alexandrefelipemuller/slowduino/resources/Schematic_Slowduino-injection_2025-11-14.png

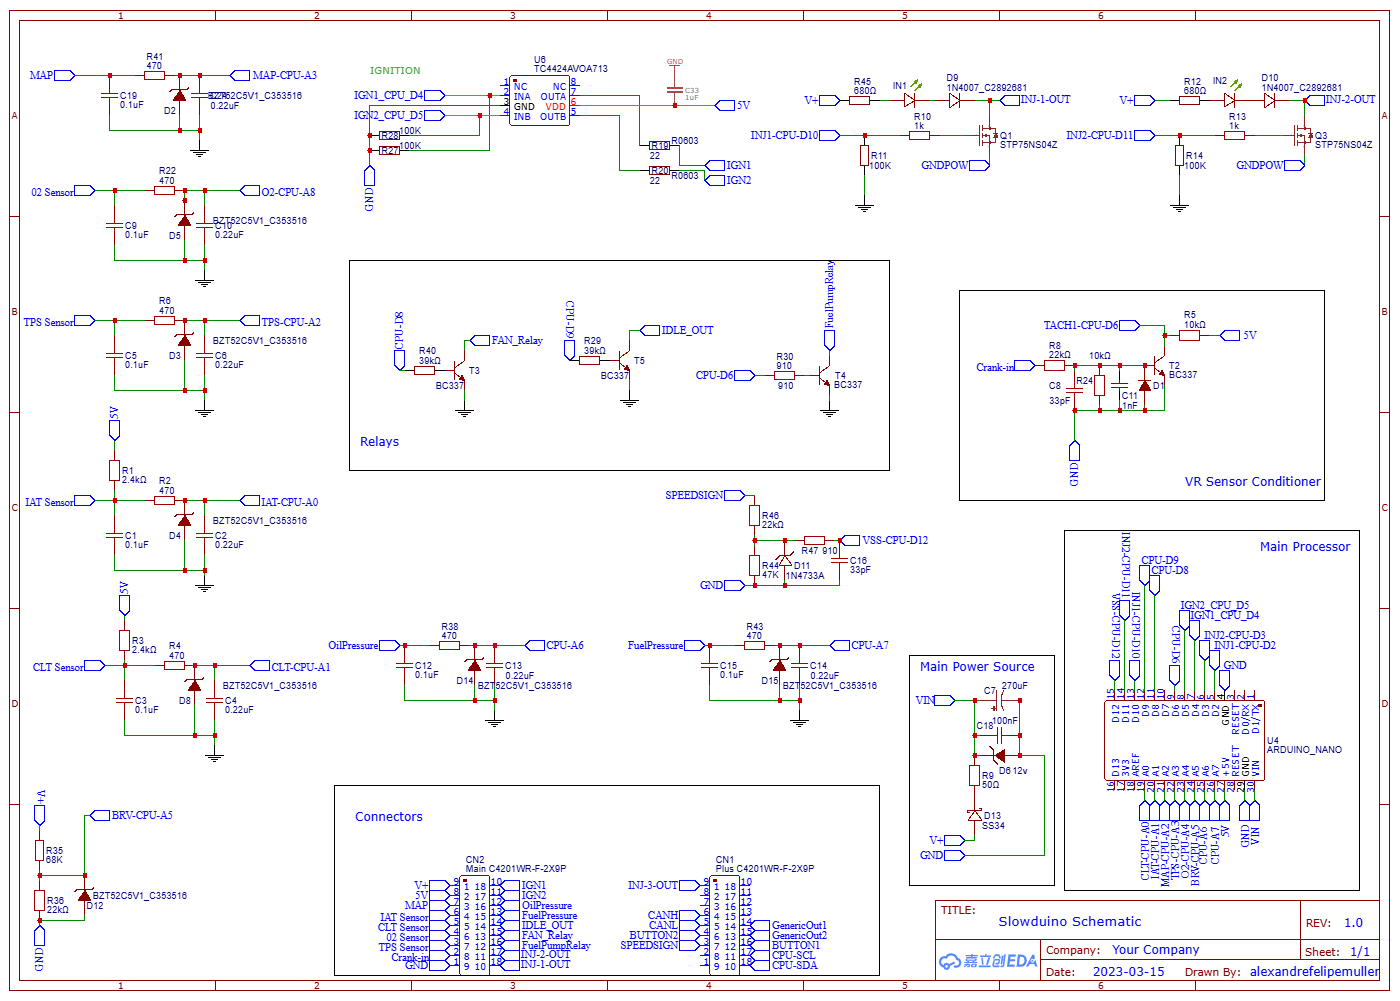
resources/Schematic_Slowduino-injection_2025-11-14.png
