alexandrefelipemuller/slowduino/resources/SlowduinoCase.stl

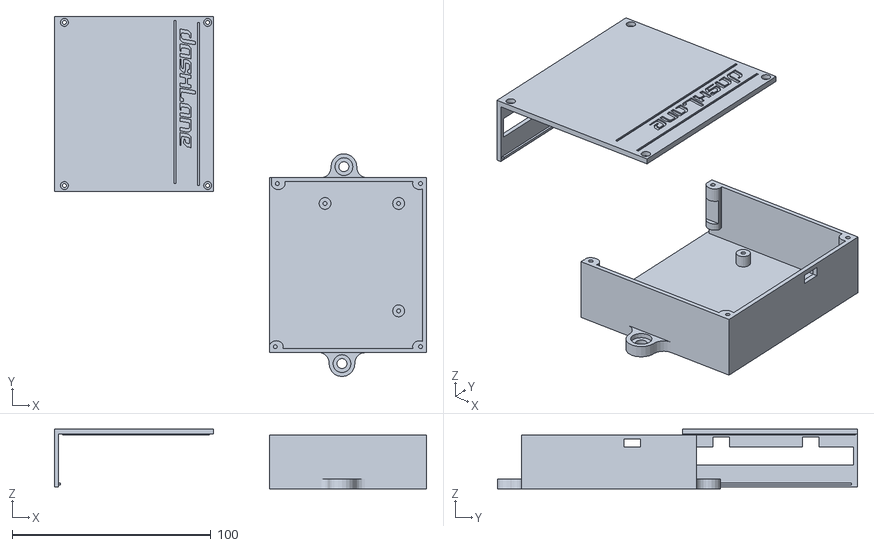
[picture p4: CAD file, 2025-11-05]
resources/SlowduinoCase.stl
187.0 x 181.0 x 30.0
