alexandrefelipemuller/slowduino/(list of files, drawings)

Other design files:
simulator/basics.sim1
