alexandrefelipemuller/slowduino/slowduino/config.h

#define CONFIG_H
#include <Arduino.h>
#include "globals.h"  // CALIB_POINTS (usado pelas tabelas de calibração padrão abaixo)
#define TABLE_SIZE_X        16   // Eixo X (RPM) - 16 pontos
#define TABLE_SIZE_Y        16   // Eixo Y (MAP/TPS) - 16 pontos
#define TIMER1_PRESCALER    256
#define TIMER1_RESOLUTION   16.0  // microsegundos por tick (não usado diretamente, apenas doc)
#define US_TO_TIMER1(us)    ((uint16_t)((us) / 16))
#define TIMER1_TO_US(ticks) ((uint32_t)(ticks) * 16U)
#define FILTER_MAP          20   // MAP: resposta rápida
#define FILTER_TPS          50   // TPS: média
#define FILTER_CLT         180   // CLT: muito filtrado (lento)
#define FILTER_IAT         180   // IAT: muito filtrado (lento)
#define FILTER_O2          128   // O2: média-alta
#define FILTER_BAT         128   // Bateria: média-alta
#define FILTER_OIL_PRESS   100   // Pressão óleo: média
#define FILTER_FUEL_PRESS  100   // Pressão combustível: média
#define ADC_MIN             0
#define ADC_MAX          1023
#define ADC_VREF         5000    // 5V
#define BAT_MULTIPLIER    767    // * 100 para evitar float
const uint16_t DEFAULT_CLT_CALIB_ADC[CALIB_POINTS] PROGMEM = {
  980, 920, 850, 750, 620, 480, 360, 120
};
const int8_t DEFAULT_CLT_CALIB_TEMP[CALIB_POINTS] PROGMEM = {
  -40,   0,  20,  40,  60,  80, 100, 127
};
const uint16_t DEFAULT_IAT_CALIB_ADC[CALIB_POINTS] PROGMEM = {
  980, 920, 850, 750, 620, 480, 360, 120
};
const int8_t DEFAULT_IAT_CALIB_TEMP[CALIB_POINTS] PROGMEM = {
  -40,   0,  20,  40,  60,  80, 100, 127
};
#define DEFAULT_O2_MIN   0
#define DEFAULT_O2_MAX   255
#define RPM_MIN              50   // RPM mínimo considerado válido
#define RPM_MAX            8000   // RPM máximo
#define CRANK_RPM           400   // Abaixo disso = partida
#define SYNC_TIMEOUT       1000   // 1 segundo sem dente = perda de sync
#define INJ_MIN_PW          500   // 0.5ms mínimo
#define INJ_MAX_PW        20000   // 20ms máximo
#define INJ_ANGLE_DEFAULT   355   // 5 graus BTDC
#define IGN_MIN_ADVANCE    -10    // 10 ATDC (retardo)
#define IGN_MAX_ADVANCE     45    // 45 BTDC
#define DWELL_MIN         1000    // 1ms mínimo
#define DWELL_MAX         8000    // 8ms máximo
#define DWELL_DEFAULT     3000    // 3ms padrão
#define CORR_BASE          100
#define CORR_MIN            50    // 50% = metade do combustível
#define CORR_MAX           200    // 200% = dobro do combustível
#define ASE_DEFAULT_PCT    150    // 150% durante ASE
#define ASE_DEFAULT_COUNT   50    // 50 ignições
#define WUE_MIN            100    // Sem enriquecimento
#define WUE_MAX            200    // Dobro
#define AE_THRESH_DEFAULT   10    // 10%/s de mudança no TPS
#define AE_PCT_DEFAULT     120    // 20% de enriquecimento
#define EGO_TYPE_OFF            0   // Sem correção
#define EGO_TYPE_NARROW         1   // Narrowband 0-1V
#define EGO_TYPE_WIDE           2   // Reservado / futuro
#define EGO_ALGO_DISABLED       0
#define EGO_ALGO_SIMPLE         1
#define EGO_DELAY_DEFAULT      30   // Segundos após motor ligado
#define EGO_TEMP_DEFAULT       60   // °C mínimo do motor
#define EGO_RPM_DEFAULT        15   // RPM / 100
#define EGO_TPS_MAX_DEFAULT    40   // TPS máximo (%)
#define EGO_MIN_DEFAULT        40   // Leituras fora disso ignoradas
#define EGO_MAX_DEFAULT       160
#define EGO_LIMIT_DEFAULT      10   // +/- %
#define EGO_STEP_DEFAULT        1   // % por iteração
#define EGO_IGN_EVENTS_DEFAULT  4   // Nº de ignições por passo
#define EGO_TARGET_DEFAULT    100   // Alvo (~lambda 1.0)
#define EGO_HYST_DEFAULT        5   // Banda morta ao redor do alvo
#define SERIAL_BAUD      115200   // Velocidade padrão TunerStudio
#define SERIAL_TIMEOUT      100   // Timeout de comando (ms)
#define CMD_READ_REALTIME   'A'   // Lê dados em tempo real
#define CMD_READ_VE         'V'   // Lê tabela VE
#define CMD_READ_IGN        'I'   // Lê tabela Ignição
#define CMD_WRITE_VE        'W'   // Escreve tabela VE
#define CMD_WRITE_IGN       'X'   // Escreve tabela Ignição
#define CMD_BURN_EEPROM     'B'   // Salva configuração
#define CMD_GET_VERSION     'Q'   // Retorna versão
#define CMD_TEST_COMMS      'T'   // Teste de comunicação
#define RESP_OK             0x00
#define RESP_ERROR          0xFF
#define EEPROM_VERSION_ADDR     0    // 1 byte - versão
#define EEPROM_VE_TABLE        10    // 256 bytes (values)
#define EEPROM_VE_AXIS_X      (EEPROM_VE_TABLE + 256)  // 32 bytes (16 × uint16_t RPM)
#define EEPROM_VE_AXIS_Y      (EEPROM_VE_AXIS_X + 32)  // 16 bytes (16 × uint8_t MAP)
#define EEPROM_IGN_TABLE      (EEPROM_VE_AXIS_Y + 16)  // 256 bytes (values)
#define EEPROM_IGN_AXIS_X     (EEPROM_IGN_TABLE + 256) // 32 bytes
#define EEPROM_IGN_AXIS_Y     (EEPROM_IGN_AXIS_X + 32) // 16 bytes
#define EEPROM_CONFIG1        (EEPROM_IGN_AXIS_Y + 16) // 128 bytes - fuel config
#define EEPROM_CONFIG2        (EEPROM_CONFIG1 + 128)   // 128 bytes - ignition config
#define EEPROM_CALIBRATION     (EEPROM_CONFIG2 + 128)  // 128 bytes
#define EEPROM_SPARE          (EEPROM_CALIBRATION + 128)
#if EEPROM_SPARE > 1024
#error "Layout EEPROM ultrapassa 1024 bytes"
#endif
extern volatile uint8_t loopTimerFlags;
#define TIMER_FLAG_4HZ        0      // 250ms - sensores lentos
#define TIMER_FLAG_15HZ       1      // ~67ms
#define TIMER_FLAG_30HZ       2      // ~33ms - sensores médios
#define TIMER_FLAG_200HZ      3      // 5ms
#define TIMER_FLAG_1KHZ       4      // 1ms - sensores rápidos
#define INJ_LAYOUT_PAIRED         0   // Wasted paired (2 canais)
#define INJ_LAYOUT_SEMI_SEQ       1   // Semi-sequential (4 canais - futuro)
#define AE_MODE_TPS               0   // Baseado em TPSdot
#define AE_MODE_MAP               1   // Baseado em MAPdot
#define LOAD_ALGORITHM_SPEED_DENSITY 0   // Carga = MAP (padrão)
#define LOAD_ALGORITHM_ALPHA_N       1   // Carga = TPS (sem sensor MAP confiável/vácuo)
#define TRIGGER_MISSING_TOOTH     0   // Missing tooth (36-1, 60-2)
#define TRIGGER_BASIC_DIST        1   // Distribuidor básico (1 dente/rev)
#define TRIGGER_EDGE_RISING       0
#define TRIGGER_EDGE_FALLING      1
#define TRIGGER_EDGE_BOTH         2
#define MAP_SAMPLE_INSTANT        0   // Leitura instantânea
#define MAP_SAMPLE_AVERAGE        1   // Média do ciclo
#define FAN_ON_TEMP         95    // Liga ventoinha em 95°C
#define FAN_OFF_TEMP        90    // Desliga em 90°C (histerese)
#define FUEL_PUMP_PRIME_MS  2000  // Prime de 2 segundos ao ligar
#define IAC_ALGORITHM_NONE      0   // Sem controle de válvula
#define IAC_ALGORITHM_PWM_OL    1   // PWM open loop (tabela por CLT)
#define IAC_ALGORITHM_PWM_OLCL  2   // PWM open loop + PID de malha fechada
#define IDLE_PWM_TICK_DIVISOR   63
#define IDLE_PWM_TICK_HZ        3968UL
#define IDLE_PWM_FREQ_MIN       16    // Hz
#define IDLE_PWM_FREQ_MAX       500   // Hz
#define IDLE_CL_RPM_WINDOW      500   // RPM
#define IDLE_INTEGRAL_LIMIT     25600L
#define IDLE_ADV_OFF            0
#define IDLE_ADV_ADDED          1   // Soma ao avanço base
#define IDLE_ADV_SWITCHED       2   // Substitui o avanço base
#define OIL_PRESS_MIN       50    // Pressão mínima óleo em idle (kPa)
#define FUEL_PRESS_MIN      250   // Pressão mínima combustível (kPa)
  #define DEBUG_PRINT(x)
  #define DEBUG_PRINTLN(x)
const uint8_t DEFAULT_VE_TABLE[TABLE_SIZE_Y][TABLE_SIZE_X] PROGMEM = {
  { 45, 47, 50, 51, 52, 53, 54, 55, 55, 56, 57, 58, 59, 60, 61, 62 },
  { 47, 50, 52, 53, 54, 55, 56, 57, 58, 59, 60, 62, 63, 64, 65, 66 },
  { 50, 52, 54, 56, 57, 58, 59, 60, 61, 62, 64, 65, 66, 68, 69, 69 },
  { 52, 54, 57, 59, 60, 62, 63, 64, 65, 67, 68, 69, 71, 72, 73, 74 },
  { 54, 57, 59, 61, 63, 65, 66, 68, 70, 71, 73, 74, 75, 77, 78, 79 },
  { 57, 59, 61, 64, 66, 68, 70, 71, 73, 75, 76, 78, 79, 80, 82, 83 },
  { 59, 61, 64, 66, 68, 71, 73, 74, 76, 78, 79, 81, 82, 84, 85, 86 },
  { 61, 64, 66, 68, 71, 73, 75, 77, 79, 81, 83, 85, 86, 87, 89, 90 },
  { 64, 66, 68, 71, 73, 75, 78, 80, 82, 84, 86, 88, 90, 91, 92, 93 },
  { 66, 68, 71, 73, 75, 78, 80, 82, 85, 87, 89, 91, 93, 94, 95, 96 },
  { 68, 71, 73, 75, 78, 80, 82, 85, 87, 89, 92, 94, 95, 96, 97, 98 },
  { 71, 73, 75, 77, 80, 82, 84, 87, 89, 91, 94, 96, 97, 98, 99,100 },
  { 73, 75, 77, 79, 81, 83, 86, 88, 90, 92, 95, 97, 98, 99,100,101 },
  { 75, 77, 78, 80, 82, 84, 87, 89, 91, 93, 96, 98, 99,100,101,102 },
  { 77, 78, 79, 81, 83, 85, 88, 90, 92, 95, 97, 99,100,101,102,104 },
  { 78, 79, 80, 82, 84, 87, 89, 91, 94, 96, 98,100,101,102,104,105 }
};
const uint16_t DEFAULT_VE_AXIS_X[TABLE_SIZE_X] PROGMEM = {
   500, 1000, 1500, 2000, 2500, 3000, 3500, 4000,
  4500, 5000, 5500, 6000, 6500, 7000, 7500, 8000
};
const uint8_t DEFAULT_VE_AXIS_Y[TABLE_SIZE_Y] PROGMEM = {
   20,  30,  40,  50,  60,  70,  80,  90,
  100, 110, 120, 130, 140, 150, 160, 170
};
const int8_t DEFAULT_IGN_TABLE[TABLE_SIZE_Y][TABLE_SIZE_X] PROGMEM = {
  { 15, 16, 18, 20, 21, 23, 25, 27, 29, 30, 31, 32, 33, 34, 35, 36 },
  { 14, 15, 16, 18, 20, 21, 23, 25, 27, 29, 29, 30, 31, 32, 33, 34 },
  { 12, 14, 15, 16, 18, 20, 21, 23, 25, 27, 28, 29, 29, 30, 31, 32 },
  { 11, 12, 14, 15, 16, 18, 20, 21, 23, 25, 26, 27, 28, 29, 29, 30 },
  { 10, 11, 12, 14, 15, 16, 18, 20, 21, 23, 24, 25, 26, 27, 28, 29 },
  {  9, 10, 11, 12, 14, 15, 16, 18, 20, 21, 22, 23, 24, 25, 26, 27 },
  {  8,  9, 10, 11, 12, 14, 15, 16, 18, 19, 20, 21, 22, 23, 24, 25 },
  {  7,  8,  9, 10, 11, 12, 14, 15, 16, 18, 19, 19, 20, 21, 22, 23 },
  {  7,  7,  8,  9, 10, 11, 12, 14, 15, 16, 17, 18, 19, 20, 21, 22 },
  {  6,  7,  8,  9, 10, 10, 11, 13, 14, 15, 16, 17, 18, 19, 20, 21 },
  {  5,  6,  7,  8,  9, 10, 11, 12, 14, 15, 16, 17, 18, 18, 19, 20 },
  {  5,  6,  7,  8,  9, 10, 10, 12, 13, 14, 15, 16, 17, 18, 19, 20 },
  {  4,  5,  6,  7,  8,  9, 10, 11, 13, 14, 15, 16, 17, 18, 18, 19 },
  {  4,  5,  6,  7,  8,  9, 10, 11, 12, 13, 14, 15, 16, 17, 18, 19 },
  {  3,  4,  5,  6,  7,  8,  9, 10, 12, 13, 14, 15, 16, 17, 18, 18 },
  {  3,  4,  5,  6,  7,  8,  9, 10, 11, 12, 13, 14, 15, 16, 17, 18 }
};
const uint16_t DEFAULT_IGN_AXIS_X[TABLE_SIZE_X] PROGMEM = {
   500, 1000, 1500, 2000, 2500, 3000, 3500, 4000,
  4500, 5000, 5500, 6000, 6500, 7000, 7500, 8000
};
const uint8_t DEFAULT_IGN_AXIS_Y[TABLE_SIZE_Y] PROGMEM = {
   20,  30,  40,  50,  60,  70,  80,  90,
  100, 110, 120, 130, 140, 150, 160, 170
};
const uint8_t DEFAULT_AFR_TABLE[TABLE_SIZE_Y][TABLE_SIZE_X] PROGMEM = {
  {110,108,106,105,104,103,102,101,100,100,100,100,100,100,100,100},
  {108,106,104,103,102,101,100,100, 98, 98, 98, 98, 98, 98, 98, 98},
  {106,104,103,102,101,100, 98, 97, 96, 96, 96, 96, 96, 96, 96, 96},
  {104,103,102,101,100, 99, 97, 96, 95, 95, 95, 95, 95, 95, 95, 95},
  {103,102,101,100, 99, 97, 96, 95, 94, 94, 94, 94, 94, 94, 94, 94},
  {102,101,100, 99, 98, 96, 95, 94, 93, 93, 93, 93, 93, 93, 93, 93},
  {101,100, 99, 98, 97, 95, 94, 93, 92, 92, 92, 92, 92, 92, 92, 92},
  {100, 99, 98, 97, 96, 94, 93, 92, 91, 91, 91, 91, 91, 91, 91, 91},
  {100, 99, 98, 97, 96, 94, 93, 92, 91, 91, 91, 91, 91, 91, 91, 91},
  {100, 99, 98, 97, 96, 94, 93, 92, 91, 91, 91, 91, 91, 91, 91, 91},
  {100, 99, 98, 97, 96, 94, 93, 92, 91, 91, 91, 91, 91, 91, 91, 91},
  {100, 99, 98, 97, 96, 94, 93, 92, 91, 91, 91, 91, 91, 91, 91, 91},
  {101,100, 99, 98, 97, 95, 94, 93, 92, 92, 92, 92, 92, 92, 92, 92},
  {102,101,100, 99, 98, 96, 95, 94, 93, 93, 93, 93, 93, 93, 93, 93},
  {103,102,101,100, 99, 97, 96, 95, 94, 94, 94, 94, 94, 94, 94, 94},
  {104,103,102,101,100, 98, 97, 96, 95, 95, 95, 95, 95, 95, 95, 95}
};
