alexandrefelipemuller/slowduino/slowduino/board_config.h

/**
 * @file board_config.h
 * @brief Configurações de hardware específicas por placa
 *
 * Define pinagem e recursos disponíveis para diferentes placas:
 * - Arduino Uno/Nano (ATmega328p) - pinagem original Slowduino
 * - Speeduino v0.4 (Arduino Mega) - pinagem compatível com hardware oficial
 */

#ifndef BOARD_CONFIG_H
#define BOARD_CONFIG_H

#include <Arduino.h>

// ============================================================================
// SELEÇÃO DE HARDWARE
// ============================================================================
//
// Descomente UMA das opções abaixo, OU defina via build flag do compilador
// (ex: "-DBOARD_SPEEDUINO_V04") sem tocar neste arquivo.
//
// Guardado com #ifndef para um -DBOARD_SPEEDUINO_V04 externo funcionar sem
// também deixar BOARD_SLOWDUINO definido ao mesmo tempo.
#if !defined(BOARD_SPEEDUINO_V04) && !defined(BOARD_STM32_BLUEPILL)
#define BOARD_SLOWDUINO      // Arduino Uno/Nano (padrão, 2 canais, 1-4 cilindros)
#endif
//#define BOARD_SPEEDUINO_V04  // Speeduino v0.4 (Arduino Mega, 4 canais, 1-8 cilindros)
//#define BOARD_STM32_BLUEPILL // STM32F103C8T6 "Blue Pill" (2 canais, 1-4 cilindros)

// ============================================================================
// DETECÇÃO AUTOMÁTICA DE PLACA (se nenhuma foi definida)
// ============================================================================
#if !defined(BOARD_SLOWDUINO) && !defined(BOARD_SPEEDUINO_V04) && !defined(BOARD_STM32_BLUEPILL)
  // Default para Arduino Uno/Nano
  #define BOARD_SLOWDUINO
#endif

// ============================================================================
// VALIDAÇÃO DE PLATAFORMA
// ============================================================================
#if defined(BOARD_SPEEDUINO_V04)
  // Speeduino v0.4 REQUER Arduino Mega (ATmega2560)
  #if !defined(__AVR_ATmega2560__) && !defined(__AVR_ATmega1280__)
    #error "BOARD_SPEEDUINO_V04 requer Arduino Mega (ATmega2560/1280)"
  #endif
#endif

#if defined(BOARD_SLOWDUINO)
  // Slowduino REQUER Arduino Uno/Nano (ATmega328p)
  #if !defined(__AVR_ATmega328P__) && !defined(__AVR_ATmega168__)
    #warning "BOARD_SLOWDUINO otimizado para ATmega328p/168 (Uno/Nano)"
  #endif
#endif

#if defined(BOARD_STM32_BLUEPILL)
  #if !defined(STM32F1xx) && !defined(ARDUINO_ARCH_STM32)
    #error "BOARD_STM32_BLUEPILL requer o core Arduino_Core_STM32 (platform ststm32)"
  #endif
#endif

// ============================================================================
// CONFIGURAÇÃO: SPEEDUINO v0.4 BOARD
// ============================================================================
#if defined(BOARD_SPEEDUINO_V04)

  #define BOARD_NAME "Speeduino v0.4 (Slowduino firmware - 2 ign ch / 4 cyl max)"
  #define BOARD_MAX_CYLINDERS 4
  #define BOARD_INJ_CHANNELS  3
  #define BOARD_IGN_CHANNELS  2

  // NOTA: Firmware Slowduino padronizado usa apenas 2 canais de ignição (wasted spark)
  //       Limitação: máximo 4 cilindros em qualquer placa

  // Entradas Digitais (Trigger)
  #define PIN_TRIGGER_PRIMARY   19  // Crank Input (VR1+) - INT2
  // PIN_TRIGGER_SECONDARY não usado (sem sensor de fase no Slowduino)

  // Saídas Digitais - Injeção (2 bancos + auxiliar)
  // Speeduino v0.4 usa drivers duplos (1/2 e 2/2 para cada canal)
  // Aqui mapeamos apenas o pino de controle principal (1/2)
  #define PIN_INJECTOR_1     8   // Injector 1 - Pin 1/2 (banco 1)
  #define PIN_INJECTOR_2     9   // Injector 2 - Pin 1/2 (banco 2)
  #define PIN_INJECTOR_3    10   // Injector auxiliar / staging
  // PIN_INJECTOR_4 não usado no firmware Slowduino

  // Saídas Digitais - Ignição (2 canais padronizados)
  #define PIN_IGNITION_1    40   // Ignition 1 (cil 1+4)
  #define PIN_IGNITION_2    38   // Ignition 2 (cil 2+3)
  // D52 permanece livre (pode virar ignição auxiliar em outro firmware)

  // Saídas Digitais - Auxiliares (Proto Area - Speeduino 0.4.4b+)
  #define PIN_FUEL_PUMP     45   // Proto Area 3 - Fuel Pump
  #define PIN_FAN           47   // Proto Area 2 - Fan
  #define PIN_IDLE_VALVE    46   // Idle 2 / PWM Idle (pin 36/37) = PL3

  // Acesso direto à porta do IAC, usado pela ISR de PWM do Timer2.
  // digitalWrite() custa ~4us e a ISR roda a 4kHz - caro demais.
  #define IDLE_PIN_HIGH()   (PORTL |= (1 << PL3))
  #define IDLE_PIN_LOW()    (PORTL &= ~(1 << PL3))

  // Outras Entradas Digitais
  #define PIN_VSS           20   // Proto Area 5 - Clutch/VSS (adaptado)

  // Entradas Analógicas (Speeduino v0.4 pinout)
  #define PIN_CLT           A0   // Coolant (CLT) - pin 19
  #define PIN_IAT           A1   // Inlet Air Temp (IAT) - pin 20
  #define PIN_O2            A2   // O2 Sensor - pin 21
  #define PIN_TPS           A3   // TPS input - pin 22
  #define PIN_MAP           A4   // MAP Sensor - pin 11
  #define PIN_BAT           A5   // Bateria (não mapeado no v0.4 padrão, usando A5)
  #define PIN_OIL_PRESSURE  A6   // Pressão óleo (adaptação, não padrão v0.4)
  #define PIN_FUEL_PRESSURE A7   // Pressão combustível (adaptação, não padrão v0.4)

  // Capacidades da placa (limitadas pelo firmware Slowduino)
  // #undef BOARD_HAS_SECONDARY_TRIGGER  (não usado)
  // #undef BOARD_SUPPORTS_SEQUENTIAL    (não implementado)

// ============================================================================
// CONFIGURAÇÃO: SLOWDUINO (Arduino Uno/Nano)
// ============================================================================
#elif defined(BOARD_SLOWDUINO)

  #define BOARD_NAME "Slowduino (Uno/Nano)"
  // ATmega328p só dispõe de 2 comparadores → padrão geral de 2 canais de ignição (4 cilindros wasted)
  #define BOARD_MAX_CYLINDERS 4
  #define BOARD_INJ_CHANNELS  3
  #define BOARD_IGN_CHANNELS  2

  // Entradas Digitais (TRIGGER PRECISA DE INT0 - SOMENTE D2 NO UNO/NANO!)
  #define PIN_TRIGGER_PRIMARY   2   // Sensor de rotação (crank) - INT0 (D2)
  // NOTA: PIN_TRIGGER_SECONDARY (D3) REMOVIDO - sem sensor de fase (wasted spark 2 canais)

  // Saídas Digitais - Ignição (wasted spark para motores 1-4 cilindros)
  #define PIN_IGNITION_1      4   // Ignição 1 (cilindros 1+4)
  #define PIN_IGNITION_2      5   // Ignição 2 (cilindros 2+5)
  // D3 fica disponível (ex: ign kill, tach, auxiliar)

  // Saídas Digitais - Injeção (2 bancos principais + canal auxiliar)
  #define PIN_INJECTOR_1     10   // Bico 1 (cilindros 1+4)
  #define PIN_INJECTOR_2     11   // Bico 2 (cilindros 2+3)
  #define PIN_INJECTOR_3      7   // Bico auxiliar / staging

  // Saídas Digitais - Auxiliares
  #define PIN_FUEL_PUMP       6   // Relé da bomba de combustível
  #define PIN_FAN             8   // Ventoinha do radiador
  #define PIN_IDLE_VALVE      9   // Selenoide de marcha lenta (IAC - PWM) = PB1

  // ATENÇÃO: D9 é OC1A. NUNCA usar analogWrite() neste pino!
  // analogWrite(9, v) do core Arduino faz sbi(TCCR1A, COM1A1) e escreve
  // OCR1A = v - e OCR1A é o compare absoluto que o scheduler usa para
  // agendar a ignição/injeção do canal 1 (scheduler.cpp). Isso destrói o
  // timing de faísca. O PWM do IAC é gerado por software na ISR do Timer2
  // (auxiliaries.cpp), que não toca em nenhum registrador do Timer1.
  #define IDLE_PIN_HIGH()     (PORTB |= (1 << PB1))
  #define IDLE_PIN_LOW()      (PORTB &= ~(1 << PB1))

  // Outras Entradas Digitais
  #define PIN_VSS            12   // Velocidade do veículo

  // Entradas Analógicas
  #define PIN_CLT             A0   // Temperatura do motor
  #define PIN_IAT             A1   // Temperatura do ar
  #define PIN_MAP             A2   // Pressão do coletor
  #define PIN_TPS             A3   // Posição da borboleta
  #define PIN_O2              A4   // Sonda Lambda
  #define PIN_BAT             A5   // Tensão da bateria
  #define PIN_OIL_PRESSURE    A6   // Pressão de óleo do motor
  #define PIN_FUEL_PRESSURE   A7   // Pressão da linha de combustível

  // Capacidades da placa
  // #undef BOARD_HAS_SECONDARY_TRIGGER  (não definido)
  // #undef BOARD_SUPPORTS_SEQUENTIAL    (não definido)

// ============================================================================
// CONFIGURAÇÃO: STM32F103C8T6 "BLUE PILL"
// ============================================================================
#elif defined(BOARD_STM32_BLUEPILL)

  // O core STM32duino já define BOARD_NAME via linha de comando (nome da
  // placa do platformio.ini) - redefine para o nosso valor sem warning.
  #undef BOARD_NAME
  #define BOARD_NAME "STM32F103C8T6 Blue Pill (Slowduino porte)"
  #define BOARD_MAX_CYLINDERS 4
  #define BOARD_INJ_CHANNELS  3
  #define BOARD_IGN_CHANNELS  2

  // Entradas Digitais (Trigger). Qualquer pino GPIO serve de EXTI no STM32 -
  // ao contrário do Uno/Nano, não há limitação de "só D2".
  #define PIN_TRIGGER_PRIMARY   PA8

  // Saídas Digitais - Ignição (wasted spark para motores 1-4 cilindros)
  #define PIN_IGNITION_1       PA9    // Cilindros 1+4
  #define PIN_IGNITION_2       PA10   // Cilindros 2+3

  // Saídas Digitais - Injeção (2 bancos principais + canal auxiliar)
  #define PIN_INJECTOR_1       PB6    // Banco 1 (1+4)
  #define PIN_INJECTOR_2       PB7    // Banco 2 (2+3)
  #define PIN_INJECTOR_3       PB8    // Auxiliar / staging

  // Saídas Digitais - Auxiliares
  #define PIN_FUEL_PUMP        PB9
  #define PIN_FAN              PB5
  #define PIN_IDLE_VALVE       PB4    // PWM por software via TIM3 (auxiliaries.cpp)

  // Acesso "rápido" ao pino do IAC. No STM32, digitalWrite() já é bem mais
  // rápido que no AVR (escreve direto em GPIOx->BSRR por baixo dos panos),
  // então não precisamos de macro de porta bruta como no AVR.
  #define IDLE_PIN_HIGH()     digitalWrite(PIN_IDLE_VALVE, HIGH)
  #define IDLE_PIN_LOW()      digitalWrite(PIN_IDLE_VALVE, LOW)

  // Outras Entradas Digitais
  #define PIN_VSS              PB3

  // Entradas Analógicas (ADC1). PA2/PA3 ficam LIVRES de propósito: são a
  // USART2, que é o `Serial` padrão do variant genérico F103C8 quando a USB
  // CDC está desligada. analogRead() nesses pinos os coloca em modo analógico
  // e mata a UART (issue #4). MAP/TPS usam PB0/PB1 (ADC1 canais 8/9).
  #define PIN_CLT              PA0
  #define PIN_IAT              PA1
  #define PIN_MAP              PB0
  #define PIN_TPS              PB1
  #define PIN_O2               PA4
  #define PIN_BAT              PA5
  #define PIN_OIL_PRESSURE     PA6
  #define PIN_FUEL_PRESSURE    PA7

#endif

// ============================================================================
// CONFIGURAÇÕES DERIVADAS
// ============================================================================

// Define número de canais disponíveis (sempre 3 no firmware Slowduino)
#if !defined(BOARD_INJ_CHANNELS) || !defined(BOARD_IGN_CHANNELS)
  #error "BOARD_INJ_CHANNELS e BOARD_IGN_CHANNELS devem ser definidos pela placa selecionada"
#endif

// ============================================================================
// INFORMAÇÕES DE DEBUG
// ============================================================================

// Macro para imprimir informações da placa no boot
#define PRINT_BOARD_INFO() \
  do { \
    Serial.print(F("Board: ")); \
    Serial.println(F(BOARD_NAME)); \
    Serial.print(F("Max Cylinders: ")); \
    Serial.println(BOARD_MAX_CYLINDERS); \
    Serial.print(F("Inj Channels: ")); \
    Serial.println(BOARD_INJ_CHANNELS); \
    Serial.print(F("Ign Channels: ")); \
    Serial.println(BOARD_IGN_CHANNELS); \
  } while(0)

#endif // BOARD_CONFIG_H
