alexandrefelipemuller/slowduino/slowduino/globals.h

/**
 * @file globals.h
 * @brief Estruturas de dados globais e definições do Slowduino
 *
 * ECU minimalista para ATmega328p (Arduino Uno/Nano)
 * Baseado na Speeduino, adaptado para limitações de memória
 */

#ifndef GLOBALS_H
#define GLOBALS_H

#include <Arduino.h>
#include "board_config.h"  // Configuração de hardware (Slowduino ou Speeduino v0.4)

// ============================================================================
// VERSÃO DO FIRMWARE
// ============================================================================
#define SLOWDUINO_VERSION "0.2.1-multi"
#define EEPROM_DATA_VERSION 6  // Bump: adicionado loadAlgorithm em ConfigPage1 (Speed-Density/Alpha-N)

// ============================================================================
// MAPEAMENTO DE PINOS
// ============================================================================
// NOTA: Pinos agora definidos em board_config.h
// Descomente BOARD_SPEEDUINO_V04 em board_config.h para usar pinagem Speeduino v0.4
// Ou deixe BOARD_SLOWDUINO (padrão) para Arduino Uno/Nano

// ============================================================================
// CONSTANTES DE CONVERSÃO
// ============================================================================
#define MICROS_PER_SEC      1000000UL
#define MICROS_PER_MIN      60000000UL
#define MILLIS_PER_SEC      1000

// Offset de temperatura para tabelas (permite temperaturas negativas)
#define TEMP_OFFSET         40

// ============================================================================
// ESTRUTURA DE STATUS ATUAL (RAM)
// ============================================================================
struct Statuses {
  // Motor
  uint16_t RPM;                // Rotações por minuto
  // RPMdiv100 removido - escrito em 5 lugares (decoders.cpp), nunca lido
  // em lugar nenhum (achado por varredura de campos mortos)
  bool hasSync;                // Motor sincronizado com trigger

  // Sensores analógicos (valores brutos ADC 0-1023)
  uint16_t mapADC;
  uint16_t tpsADC;
  uint16_t cltADC;
  uint16_t iatADC;
  uint16_t o2ADC;
  uint16_t batADC;
  uint16_t oilPressADC;
  uint16_t fuelPressADC;

  // Sensores convertidos (valores físicos)
  uint8_t  MAP;                // Pressão kPa (0-255)
  uint8_t  TPS;                // Posição borboleta % (0-100)
  int8_t   coolant;            // Temperatura motor °C (-40 a +215)
  int8_t   IAT;                // Temperatura ar °C (-40 a +215)
  uint8_t  O2;                 // Lambda % (0-255, 100 = lambda 1.0)
  uint8_t  afrTarget;          // AFR target (same scale as O2)
  uint8_t  battery10;          // Tensão bateria * 10 (ex: 145 = 14.5V)
  uint8_t  oilPressure;        // Pressão óleo kPa (0-1000 kPa)
  uint8_t  fuelPressure;       // Pressão combustível kPa (0-1000 kPa)

  // Combustível (2 bancos principais + canal auxiliar opcional)
  uint16_t PW1;                // Pulsewidth injetor 1 (microsegundos) - bancadas 1+4
  uint16_t PW2;                // Pulsewidth injetor 2 - bancadas 2+3 (motores 4c)
  uint16_t PW3;                // Pulsewidth auxiliar (staged / nitro / boost)
  uint8_t  VE;                 // Volumetric Efficiency % (0-255)
  uint16_t corrections;        // Correções acumuladas (base 100)

  // Ignição
  int8_t   advance;            // Avanço de ignição (graus BTDC)
  uint16_t dwell;              // Tempo de carga da bobina (microsegundos)


  // Correções individuais (para debug/tuning via datalog)
  // Removidos aseCorrection/aeCorrection/cltCorrection/egoCorrection -
  // escritos (ou nem isso, no caso de egoCorrection) mas nunca lidos por
  // nada, nem pelo pacote realtime. wueCorrection e batCorrection ficam
  // porque comms.cpp os manda no datalog.
  uint8_t  wueCorrection;      // Warm-Up Enrichment %
  uint8_t  batCorrection;      // Battery correction %

  // Estado do motor
  uint8_t  engineStatus;       // Flags de estado (bit field)
  uint8_t  protectionStatus;   // Bits de proteção (RPM/óleo)

  // Auxiliares (outputs)
  bool     fanActive;          // Ventoinha ativa
  bool     fuelPumpActive;     // Bomba de combustível ativa
  uint8_t  idleValveDuty;      // Duty cycle válvula marcha lenta (0-100%)
  uint16_t CLIdleTarget;       // Alvo de RPM da marcha lenta (interpolado de iacCLValues)
  uint8_t  idleTaper;          // Contador da transição partida->run (décimos de s)

  // Tempo
  uint32_t secl;               // Segundos desde power-on
  uint32_t runSecs;            // Segundos de funcionamento (RPM > 0)

  // TPS rate of change
  int16_t  TPSdot;             // Taxa de mudança TPS (%/s)
  uint8_t  TPSlast;            // TPS anterior

  // loopCount removido (0 usos em todo o projeto) e ignitionCount removido
  // (só incrementado em scheduler.cpp, nunca lido)
};

// Flags de engineStatus
#define ENGINE_CRANK        0  // Bit 0: Motor em partida
#define ENGINE_RUN          1  // Bit 1: Motor funcionando
#define ENGINE_ASE          2  // Bit 2: After-Start Enrichment ativo
#define ENGINE_WARMUP       3  // Bit 3: Aquecimento ativo
#define ENGINE_ACC          4  // Bit 4: Aceleração detectada
#define ENGINE_DEC          5  // Bit 5: Desaceleração detectada

extern struct Statuses currentStatus;

// ============================================================================
// CONFIGURAÇÃO DE COMBUSTÍVEL (EEPROM)
// ============================================================================
struct ConfigPage1 {
  // Configuração do motor
  uint8_t  nCylinders;         // Número de cilindros (1-4, 2 canais wasted)

  // Required fuel
  uint16_t reqFuel;            // Required fuel em microsegundos (base para cálculo de PW)
  uint16_t injOpen;            // Tempo de abertura do injetor (microsegundos)

  // Calibração TPS
  uint8_t  tpsMin;             // ADC em 0% (0-255 mapeado de 0-1023)
  uint8_t  tpsMax;             // ADC em 100%
  uint8_t  tpsFilter;          // Constante de filtro (0-240)

  // Calibração MAP
  uint8_t  mapMin;             // kPa em ADC mínimo
  uint8_t  mapMax;             // kPa em ADC máximo
  uint8_t  mapFilter;          // Constante de filtro

  // Algoritmo de carga: 0=Speed-Density (MAP), 1=Alpha-N (TPS)
  uint8_t  loadAlgorithm;

  // Warm-Up Enrichment (6 pontos)
  uint8_t  wueBins[6];         // Temperaturas (-40 a +100°C)
  uint8_t  wueValues[6];       // Enriquecimento % (100-200)

  // After-Start Enrichment
  uint8_t  asePct;             // % de enriquecimento (100-200)
  uint8_t  aseCount;           // Número de ciclos (ignições)

  // Acceleration Enrichment
  uint8_t  aeMode;             // 0=TPS, 1=MAP
  uint8_t  aeThresh;           // Threshold para ativar (%/s ou kPa/s)
  uint8_t  aePct;              // % de enriquecimento

  // Priming pulse
  uint8_t  primePulse;         // Pulso de prime (ms * 10)

  // Cranking
  uint8_t  crankRPM;           // RPM máximo para considerar cranking

  // Proteção de pressão de óleo
  uint8_t  oilPressureProtEnable;     // 0=Off, 1=On
  uint8_t  oilPressureProtThreshold;  // Limite (0-250 scale)
  uint8_t  oilPressureProtHysteresis; // Histeresis
  uint8_t  oilPressureProtDelay;      // Delay ticks

  // Reserva para compatibilidade com Speeduino (página 1 = 128 bytes).
  // Cresceu de 76 para 94 bytes: removidos injectorLayout, divider,
  // mapSample, aeTime, stoich e o cluster egoType..egoHysteresis (13
  // campos) - achados numa varredura de campos mortos (escritos em
  // loadDefaults(), nunca lidos por nada - o closed-loop de O2 não tem
  // nenhuma linha de código implementada em fuel.cpp/sensors.cpp, apesar
  // do que docs/specifications.md descreve). Ficam reservados aqui em vez
  // de reaproveitados por outro campo, preservando os 128 bytes da página.
  // Reduzido para 93 bytes: 1 byte cedido ao novo campo loadAlgorithm.
  uint8_t  spare[93];

} __attribute__((packed));

extern struct ConfigPage1 configPage1;

// ============================================================================
// CONFIGURAÇÃO DE IGNIÇÃO (EEPROM)
// ============================================================================
struct ConfigPage2 {
  // Trigger
  uint8_t  triggerPattern;     // 0=Missing Tooth, 1=Basic Distributor
  uint8_t  triggerTeeth;       // Dentes totais (ex: 36 para 36-1)
  uint8_t  triggerMissing;     // Dentes faltantes (ex: 1 para 36-1)
  // triggerAngle removido (escrito, nunca lido) - byte reservado no spare[]

  // Dwell
  uint16_t dwellRun;           // Dwell em funcionamento (microsegundos)
  uint16_t dwellCrank;         // Dwell em partida (microsegundos)
  uint16_t dwellLimit;         // Limite máximo (proteção)

  // Timing
  int8_t   crankAdvance;       // Avanço durante partida (graus)

  // Rev Limiter
  uint8_t  revLimitRPM;        // RPM / 100 (ex: 60 = 6000 RPM)

  // idleAdvance e idleRPM removidos - legado desde a reescrita do idle
  // advance (o alvo real vem de iacCLValues), escritos em loadDefaults()
  // mas nunca lidos por nada. Bytes reservados no spare[].

  // CLT advance correction (4 pontos)
  int8_t   cltAdvBins[4];      // Temperaturas
  int8_t   cltAdvValues[4];    // Avanço adicional (graus, pode ser negativo)

  // Ignition output
  uint8_t  ignInvert;          // 0=Normal, 1=Invertido

  // Trigger edge (como na Speeduino)
  uint8_t  triggerEdge;        // 0=Rising, 1=Falling, 2=Both (CHANGE)

  // Proteções adicionais do motor
  uint8_t  engineProtectEnable;         // 0=Off, 1=On
  uint8_t  engineProtectRPM;            // RPM / 100
  uint8_t  engineProtectRPMHysteresis;  // RPM / 100
  // engineProtectCutType removido - protectionProcess() só calcula um
  // bitmask (protectionStatus); protectionRPMActive()/protectionOilActive()
  // nunca são chamadas por ninguém, então nada nunca consultou este campo
  // para decidir fuel-cut vs spark-cut de fato. Byte reservado no spare[].

  // ==========================================================================
  // Válvula de marcha lenta (IAC) - PWM open loop + closed loop
  // ==========================================================================
  uint8_t  iacAlgorithm;       // 0=None, 1=PWM open loop, 2=PWM OL+CL
  uint8_t  idleFreq;           // Frequência do PWM / 2 (ex: 80 = 160 Hz)

  int8_t   iacBins[4];         // Bins de CLT (°C) das 3 curvas abaixo
  uint8_t  iacOLPWMVal[4];     // Duty open loop por CLT (%)
  uint8_t  iacCLValues[4];     // Alvo de RPM por CLT / 10 (ex: 85 = 850 RPM)

  int8_t   iacCrankBins[4];    // Bins de CLT durante a partida (°C)
  uint8_t  iacCrankDuty[4];    // Duty durante a partida (%)

  uint8_t  idleKP;             // Ganho proporcional (escala 1/16)
  uint8_t  idleKI;             // Ganho integral (escala 1/16)
  uint8_t  idleKD;             // Ganho derivativo (escala 1/16)

  uint8_t  iacCLminValue;      // Duty mínimo da malha fechada (%)
  uint8_t  iacCLmaxValue;      // Duty máximo da malha fechada (%)
  uint8_t  idleTaperTime;      // Transição partida->run (décimos de segundo)
  uint8_t  iacTPSlimit;        // Acima deste TPS (%), reseta a integral do PID

  // ==========================================================================
  // Idle advance (correção de ignição em marcha lenta)
  // ==========================================================================
  uint8_t  idleAdvEnabled;     // 0=Off, 1=Added, 2=Switched
  uint8_t  idleAdvTPS;         // TPS máximo para atuar (%)
  uint8_t  idleAdvRPM;         // RPM máximo para atuar / 100
  uint8_t  idleAdvBins[4];     // Delta de RPM (alvo - atual) / 10
  int8_t   idleAdvValues[4];   // Avanço adicional (graus, pode ser negativo)

  // Reserva para compatibilidade com Speeduino (página 4 = 128 bytes).
  // Cresceu de 60 para 64 bytes: removidos triggerAngle, idleAdvance,
  // idleRPM e engineProtectCutType (4 campos mortos - ver comentários
  // acima), preservando os 128 bytes da página.
  uint8_t  spare[64];

} __attribute__((packed));

extern struct ConfigPage2 configPage2;

// ============================================================================
// CALIBRAÇÃO DE SENSORES CLT/IAT/O2 (EEPROM, página 6)
// ============================================================================
// Curvas editáveis pelo TunerStudio (Settings > Calibration). Substituem a
// tabela NTC fixa em sensors.cpp (ntcToCelsius) por pontos ADC->°C
// configuráveis por sensor. O2 usa calibração linear min/max, no mesmo
// padrão de tpsMin/tpsMax em ConfigPage1.
#define CALIB_POINTS 8

struct CalibrationConfig {
  // CLT: pontos ADC (10-bit, decrescente) -> temperatura °C
  uint16_t cltAdcBins[CALIB_POINTS];
  int8_t   cltTempValues[CALIB_POINTS];

  // IAT: mesma estrutura, curva independente
  uint16_t iatAdcBins[CALIB_POINTS];
  int8_t   iatTempValues[CALIB_POINTS];

  // O2: calibração linear (ADC 8-bit, mesma escala de tpsMin/tpsMax)
  uint8_t  o2Min;              // ADC (0-255) correspondente a O2=0
  uint8_t  o2Max;              // ADC (0-255) correspondente a O2=255

  // Reserva para manter a página em 128 bytes (compatibilidade wire protocol)
  // Fixo = 2 curvas * (uint16_t + int8_t) * CALIB_POINTS + o2Min + o2Max
  uint8_t  spare[128 - (6 * CALIB_POINTS + 2)];

} __attribute__((packed));

extern struct CalibrationConfig calibrationConfig;

static_assert(sizeof(ConfigPage1) == 128, "ConfigPage1 deve ocupar 128 bytes");
static_assert(sizeof(ConfigPage2) == 128, "ConfigPage2 deve ocupar 128 bytes");
static_assert(sizeof(CalibrationConfig) == 128, "CalibrationConfig deve ocupar 128 bytes");

// ============================================================================
// MACROS ÚTEIS
// ============================================================================

// Manipulação de bits
#define BIT_SET(var, bit)    ((var) |= (1 << (bit)))
#define BIT_CLEAR(var, bit)  ((var) &= ~(1 << (bit)))
#define BIT_CHECK(var, bit)  ((var) & (1 << (bit)))
#define BIT_TOGGLE(var, bit) ((var) ^= (1 << (bit)))

// Conversão rápida de ADC 10-bit para 8-bit
#define ADC_10_TO_8(x)  ((x) >> 2)

// Percentual (evita overflow em multiplicação)
#define PERCENT(val, pct) (((uint32_t)(val) * (pct)) / 100)

// Protections
#define PROTECTION_RPM_BIT 0x01
#define PROTECTION_OIL_BIT 0x02
// ENGINE_PROTECT_CUT_FUEL/SPARK removidos junto com engineProtectCutType
// (bloco estava duplicado; as macros não tinham mais nenhum uso)

// Map rápido (assumindo range específico)
inline uint16_t fastMap(uint16_t x, uint16_t in_min, uint16_t in_max, uint16_t out_min, uint16_t out_max) {
  return (x - in_min) * (out_max - out_min) / (in_max - in_min) + out_min;
}

#endif // GLOBALS_H
