alexandrefelipemuller/slowduino/slowduino/tables.cpp

/**
 * @file tables.cpp
 * @brief Implementação de tabelas e interpolação
 */

#include "tables.h"

// ============================================================================
// INSTANCIAÇÃO DAS TABELAS GLOBAIS
// ============================================================================

struct Table3D veTable;
struct Table3D ignTable;

// ============================================================================
// INICIALIZAÇÃO DAS TABELAS
// ============================================================================

void initTables() {
  // Inicializa flags de tipo
  veTable.isSigned = false;   // VE usa valores unsigned
  ignTable.isSigned = true;   // Ignição usa valores signed (pode ser negativo)

  // Limpa cache
  clearTableCaches();
}

// ============================================================================
// INTERPOLAÇÃO 3D (Bilinear)
// ============================================================================

int16_t getTableValue(struct Table3D* table, uint8_t valueY, uint16_t valueX) {
  // Verifica cache
  if (table->lastInputX == valueX && table->lastInputY == valueY) {
    return table->lastOutput;
  }

  // Encontra índices nos eixos
  uint8_t xLow, xHigh, yLow, yHigh;
  findTableXIndices(table, valueX, &xLow, &xHigh);
  findTableYIndices(table, valueY, &yLow, &yHigh);

  // Valores nos 4 cantos do retângulo
  int16_t q11, q21, q12, q22;

  if (table->isSigned) {
    q11 = table->valuesI[yLow][xLow];
    q21 = table->valuesI[yLow][xHigh];
    q12 = table->valuesI[yHigh][xLow];
    q22 = table->valuesI[yHigh][xHigh];
  } else {
    q11 = table->valuesU[yLow][xLow];
    q21 = table->valuesU[yLow][xHigh];
    q12 = table->valuesU[yHigh][xLow];
    q22 = table->valuesU[yHigh][xHigh];
  }

  // Caso especial: se índices são iguais, não precisa interpolar
  if (xLow == xHigh && yLow == yHigh) {
    table->lastOutput = q11;
    table->lastInputX = valueX;
    table->lastInputY = valueY;
    table->lastX = xLow;
    table->lastY = yLow;
    return q11;
  }

  // Valores dos eixos nos 4 cantos
  uint16_t x1 = table->axisX[xLow];
  uint16_t x2 = table->axisX[xHigh];
  uint8_t y1 = table->axisY[yLow];
  uint8_t y2 = table->axisY[yHigh];

  // Interpolação bilinear
  int16_t result;

  if (xLow == xHigh) {
    // Só interpola em Y
    result = interpolate(valueY, y1, y2, q11, q12);
  } else if (yLow == yHigh) {
    // Só interpola em X
    result = interpolate(valueX, x1, x2, q11, q21);
  } else {
    // Interpolação bilinear completa
    // Primeiro interpola em X para obter R1 e R2
    int16_t r1 = interpolate(valueX, x1, x2, q11, q21);  // Linha inferior
    int16_t r2 = interpolate(valueX, x1, x2, q12, q22);  // Linha superior

    // Depois interpola em Y entre R1 e R2
    result = interpolate(valueY, y1, y2, r1, r2);
  }

  // Atualiza cache
  table->lastOutput = result;
  table->lastInputX = valueX;
  table->lastInputY = valueY;
  table->lastX = xLow;
  table->lastY = yLow;

  return result;
}

// ============================================================================
// BUSCA DE ÍNDICES
// ============================================================================

void findTableXIndices(struct Table3D* table, uint16_t value, uint8_t* idxLow, uint8_t* idxHigh) {
  // Verifica limites inferiores
  if (value <= table->axisX[0]) {
    *idxLow = 0;
    *idxHigh = 0;
    return;
  }

  // Verifica limites superiores
  if (value >= table->axisX[TABLE_SIZE_X - 1]) {
    *idxLow = TABLE_SIZE_X - 1;
    *idxHigh = TABLE_SIZE_X - 1;
    return;
  }

  // Busca linear (tabela pequena, busca binária não compensa)
  // Começa do último índice usado (provável estar próximo)
  uint8_t startIdx = table->lastX;

  // Busca para frente
  for (uint8_t i = startIdx; i < TABLE_SIZE_X - 1; i++) {
    if (value >= table->axisX[i] && value < table->axisX[i + 1]) {
      *idxLow = i;
      *idxHigh = i + 1;
      return;
    }
  }

  // Se não encontrou, busca para trás
  for (int8_t i = startIdx - 1; i >= 0; i--) {
    if (value >= table->axisX[i] && value < table->axisX[i + 1]) {
      *idxLow = i;
      *idxHigh = i + 1;
      return;
    }
  }

  // Fallback (não deveria chegar aqui)
  *idxLow = TABLE_SIZE_X - 2;
  *idxHigh = TABLE_SIZE_X - 1;
}

void findTableYIndices(struct Table3D* table, uint8_t value, uint8_t* idxLow, uint8_t* idxHigh) {
  // Verifica limites inferiores
  if (value <= table->axisY[0]) {
    *idxLow = 0;
    *idxHigh = 0;
    return;
  }

  // Verifica limites superiores
  if (value >= table->axisY[TABLE_SIZE_Y - 1]) {
    *idxLow = TABLE_SIZE_Y - 1;
    *idxHigh = TABLE_SIZE_Y - 1;
    return;
  }

  // Busca linear otimizada
  uint8_t startIdx = table->lastY;

  // Busca para frente
  for (uint8_t i = startIdx; i < TABLE_SIZE_Y - 1; i++) {
    if (value >= table->axisY[i] && value < table->axisY[i + 1]) {
      *idxLow = i;
      *idxHigh = i + 1;
      return;
    }
  }

  // Busca para trás
  for (int8_t i = startIdx - 1; i >= 0; i--) {
    if (value >= table->axisY[i] && value < table->axisY[i + 1]) {
      *idxLow = i;
      *idxHigh = i + 1;
      return;
    }
  }

  // Fallback
  *idxLow = TABLE_SIZE_Y - 2;
  *idxHigh = TABLE_SIZE_Y - 1;
}

// ============================================================================
// INTERPOLAÇÃO 2D (Linear)
// ============================================================================

uint8_t getTable2DValue(struct Table2D* table, int8_t value) {
  // Verifica cache
  if (table->lastInput == value) {
    return table->lastOutput;
  }

  // Verifica limites
  if (value <= table->bins[0]) {
    table->lastOutput = table->values[0];
    table->lastInput = value;
    table->lastBin = 0;
    return table->values[0];
  }

  if (value >= table->bins[table->size - 1]) {
    table->lastOutput = table->values[table->size - 1];
    table->lastInput = value;
    table->lastBin = table->size - 1;
    return table->values[table->size - 1];
  }

  // Busca linear
  for (uint8_t i = 0; i < table->size - 1; i++) {
    if (value >= table->bins[i] && value < table->bins[i + 1]) {
      // Interpola
      uint8_t result = interpolate(
        value,
        table->bins[i],
        table->bins[i + 1],
        table->values[i],
        table->values[i + 1]
      );

      table->lastOutput = result;
      table->lastInput = value;
      table->lastBin = i;
      return result;
    }
  }

  // Fallback
  return table->values[table->size - 1];
}

// ============================================================================
// CURVAS PEQUENAS SEM ESTADO (config pages)
// ============================================================================

uint8_t lookupCurveU8(const int8_t* bins, const uint8_t* values, uint8_t size, int16_t x) {
  if (size == 0) return 0;
  if (x <= bins[0]) return values[0];
  if (x >= bins[size - 1]) return values[size - 1];

  for (uint8_t i = 0; i < size - 1; i++) {
    if (x >= bins[i] && x < bins[i + 1]) {
      return (uint8_t)interpolate(x, bins[i], bins[i + 1], values[i], values[i + 1]);
    }
  }

  return values[size - 1];
}

int8_t lookupCurveI8(const uint8_t* bins, const int8_t* values, uint8_t size, int16_t x) {
  if (size == 0) return 0;
  if (x <= (int16_t)bins[0]) return values[0];
  if (x >= (int16_t)bins[size - 1]) return values[size - 1];

  for (uint8_t i = 0; i < size - 1; i++) {
    if (x >= (int16_t)bins[i] && x < (int16_t)bins[i + 1]) {
      return (int8_t)interpolate(x, bins[i], bins[i + 1], values[i], values[i + 1]);
    }
  }

  return values[size - 1];
}

// ============================================================================
// UTILITÁRIOS
// ============================================================================

void clearTableCaches() {
  veTable.lastInputX = 0xFFFF;
  veTable.lastInputY = 0xFF;
  veTable.lastX = 0;
  veTable.lastY = 0;

  ignTable.lastInputX = 0xFFFF;
  ignTable.lastInputY = 0xFF;
  ignTable.lastX = 0;
  ignTable.lastY = 0;
}
