alexandrefelipemuller/slowduino/(commit log)

2025-11-05 cleaning directories
    [SlowduinoCase.stl]
2025-11-06 mudancas de portas
2025-11-10 Correção calculo sensor rotacao
2025-11-12 Correções e melhorias
    [basics.sim1]
2025-11-13 suporte a speeduino board 0.4
2025-11-14 Correção de eventos ignicao e injeção
    [basics.sim1]
2025-11-15 atualização do readme e do board
2025-11-20 Correção do projeto
    [basics.sim1]
2025-11-20 Correção geral
    [basics.sim1]
2026-07-25 Adiciona rejeição de ruído e tolerância adaptativa ao decoder Missing Tooth
    Porta melhorias observadas no decoder do projeto Autoino: rejeita pulsos
    muito curtos em relação ao gap de referência (ruído/EMI causando double-
    trigger), relaxa o threshold de gap e a janela de validação de dentes
    durante cranking (mais jitter no sinal nessa fase) e força reset da
    contagem se nenhum gap for detectado por tempo demais.
    [decoders.cpp]
2026-07-25 Corrige corrida entre escrita do OCR1x e o Timer1 já ter passado do alvo
    Timer1 roda em modo Normal (free-running, sem reset no compare match).
    Se TCNT1 avançar além do valor calculado antes da escrita em OCR1A/OCR1B
    (ex: por atraso de interrupção), o compare match só dispararia ~1s depois,
    na próxima volta do contador de 16 bits, perdendo o evento de ignição
    silenciosamente. Inspirado na guarda equivalente do scheduler do Autoino:
    após escrever o registrador, verifica se o alvo já foi ultrapassado e,
    nesse caso, processa o evento imediatamente em vez de esperar o wraparound.
    [scheduler.cpp]
2026-07-25 Corrige colisão entre prime pulse e injeção real no primeiro sync
    O prime pulse chamava openInjector1/2()/closeInjector1/2() direto no pino,
    por fora da máquina de estados de polling usada pela injeção normal
    (injector1Polling/injector2Polling). Como o mesmo evento de trigger que
    adquire sync já agenda uma injeção real via scheduleInjectorPolling(), as
    duas lógicas disputavam o mesmo pino sem coordenação: o fechamento de uma
    podia cortar o pulso da outra logo na primeira sincronização do motor
    (ex: prime cortado por closeInjector1() de uma injeção real, ou vice-versa).
    Agora o prime pulse é agendado pela mesma fila de polling (delay 0),
    eliminando a via alternativa de contr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
    [slowduino.ino]
2026-07-25 Protege escrita de PW1/PW2/advance/dwell contra leitura torta pela ISR
    currentStatus.PW1/PW2/dwell são uint16_t escritos no loop principal e lidos
    diretamente pela ISR do trigger (scheduleInjectionISR/scheduleIgnitionISR).
    Em AVR, escrita/leitura de 16 bits não é atômica: se a ISR disparasse no
    meio da atribuição, podia ler um valor com metade do byte antigo e metade
    do novo, produzindo um PW ou dwell errado para aquele evento. Os cálculos
    continuam fora da seção crítica; só a publicação dos valores em
    currentStatus é protegida com noInterrupts()/interrupts().
2026-07-25 Remove delayMicroseconds(100) incondicional no fim do loop principal
    Esse delay rodava em toda iteração independente de RPM, somando-se ao
    tempo já gasto com comms/sensores/EEPROM e alargando a janela de latência
    do polling de injetores (processInjectorPolling) e do processamento de
    comandos seriais. O próprio comentário já indicava que era removível em
    produção; sem carga real de CPU justificando o delay, é só overhead de
    timing.
2026-07-28 controle da lenta a correção de bugs
    [auxiliaries.cpp, auxiliaries.h, board_config.h, comms.cpp, config.h, globals.h, ignition.cpp, ignition.h]
2026-07-29 Corrige seleção de placa por build flag e remove código morto (1464->1446B RAM)
    Portado da branch ms1 (experimento de RAM), só o que é seguro e vantajoso
    independente de qualquer aperto de RAM - sem tocar em protocolo/tamanho de
    página:
    - board_config.h: BOARD_SLOWDUINO agora guardado com
    #ifndef BOARD_SPEEDUINO_V04, para permitir selecionar a placa via build
    flag do compilador sem deixar as duas definidas ao mesmo tempo.
    - Tipos estreitados (achados numa análise comparativa com o firmware MS1):
    aseCounter/aseValue (fuel.cpp) uint16_t->uint8_t; expectedLength
    (comms.cpp) uint16_t->uint8_t, com o parse do header mantido num uint16_t
    local até validar o tamanho (senão trun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
    [auxiliaries.cpp, board_config.h, comms.cpp, decoders.cpp, fuel.cpp, globals.h, scheduler.cpp, slowduino.ino]
2026-08-18 Assinatura serial própria do Slowduino + projeto TunerStudio adaptado
    O firmware não se identifica mais como "Speeduino 202402" nos comandos
    I/Q/S (legacy e modern protocol) - agora responde "Slowduino 202402",
    evitando colisão com ferramentas do Speeduino real.
    Adiciona tunerstudio/slowduino_202402.ini: projeto TunerStudio próprio,
    com as páginas 1 (ConfigPage1) e 4 (ConfigPage2) remapeadas campo a
    campo para os structs reais do firmware, enums restritos aos valores
    de fato implementados, e páginas 5-15 (AFR/boost/VVT/CAN/staged/WMI)
    tiradas do menu por serem apenas stubs de protocolo sem efeito real.
    signature do .ini casa com a nova assinatura do firmware.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
2026-08-23 Implementa persistência de calibração CLT/IAT/O2 e corrige offsets do .ini
    Páginas 6 (calibração de sensores) agora são persistidas de verdade em
    EEPROM em vez de TODOs vazios que descartavam os writes do TunerStudio
    silenciosamente. CLT/IAT usam curvas de 8 pontos ADC->°C editáveis;
    O2 usa min/max linear igual a tpsMin/tpsMax.
    Durante a implementação foi encontrado que o .ini das páginas 1 e 4
    ainda referenciava campos removidos num refactor anterior do firmware,
    deixando todos os offsets a partir de tpsMin (página 1) e de dwellRun
    em diante (página 4) desalinhados com os structs reais - qualquer
    escrita nesses campos via TunerStudio ia parar no campo errado da
    EEPROM. Corrig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
    [comms.cpp, config.h, globals.cpp, globals.h, sensors.cpp, sensors.h, storage.cpp]
2026-08-27 Corrige sintaxe do .ini do TunerStudio (Gauge, FrontPage, Menu, Datalog)
    Vários blocos usavam sintaxe inventada que o parser do TunerStudio não
    reconhece: "Gauge = " como palavra-chave, gaugeColumns em [FrontPage],
    subMenu fora de um menu pai, um [UserDefined]/"steps=" sem equivalente
    real, e possibleLoggerFields/logEntry em vez de "entry =" no [Datalog].
    Corrigido comparando com o speeduino.ini oficial.
    Claude-Session: https://claude.ai/code/session_01UzHnF7GQrDrbP2b4FX5mYG
2026-08-28 Corrige protocolo TunerStudio: assinatura, boot silencioso, buffer, EEPROM e offset byte
    Vários bugs isolados via teste real com TunerStudio + PICSimLab + simavr:
    - comms.cpp: assinatura volta a começar com "speeduino" (agora
    "speeduino 202402(s)") - o TunerStudio (ao menos a variante MS Lite)
    rejeita como "Unsupported Controller Firmware" qualquer assinatura que
    não bata com sua whitelist interna de firmwares conhecidos, independente
    do .ini. É a causa da regressão desde que o projeto passou a se
    identificar como "slowduino 202402".
    - slowduino.ino: banner de boot roteado pelas macros DEBUG_PRINT/PRINTLN
    (config.h) em vez de Serial.print/println direto - antes era sempre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
    [comms.cpp, comms.h, config.h, slowduino.ino, storage.cpp]
2026-08-28 Corrige estrutura do .ini: dialogs vivem em [UserDefined], nao em [Menu]
    Confirmado testando ao vivo com TunerStudio: nenhum dos "dialog = "
    definidos dentro de [Menu] (nem antes, numa seção "[Dialog]" própria)
    era reconhecido - toda entrada de menu dava "X not found in current
    configuration. Perhaps it hasn't been created."
    Comparando com o speeduino.ini oficial: entre [Menu] e [CurveEditor] há
    duas seções que passaram despercebidas numa primeira olhada,
    [SettingContextHelp] e [UserDefined] - é dentro de [UserDefined] que
    todos os "dialog = " realmente vivem (documentado no próprio ini real:
    "Enhanced TunerStudio dialogs can be defined here").
    Testado: Engine Constants, Trigger &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
2026-08-28 Adiciona platformio.ini para builds locais (uno/mega2560)
    Não faz parte do fluxo oficial do projeto (Arduino IDE), só facilita
    gerar .hex reproduzíveis pra testar em simulador/hardware sem abrir a
    IDE - usado para validar as correções de protocolo desta sessão.
    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
2026-08-31 Adiciona suporte a Alpha-N e corrige doc de reqFuel
    Novo campo configPage1.loadAlgorithm permite escolher entre Speed-Density
    (MAP, padrão) e Alpha-N (TPS) como carga primária para VE table e ignition
    table, selecionável via TunerStudio (.ini atualizado, offsets de
    ConfigPage1 realinhados, EEPROM_DATA_VERSION bump para 6).
    Corrige docs/getting-started.md: a fórmula de reqFuel resultava em ms mas
    o campo é armazenado em microssegundos (mesma unidade de injOpen).
    Claude-Session: https://claude.ai/code/session_01C13FPY7JPixoQrchj2f1GQ
    [config.h, fuel.cpp, globals.h, ignition.cpp, storage.cpp]
2026-08-31 Corrige agendamento de ignicao (wraparound + evento descartado) e fecha loop de validacao no simulador
    Dois bugs reais no scheduler de ignicao (Timer1):
    - handleIgnitionChannel() nao tinha guarda de wraparound no fim do dwell
    (so no inicio), deixando a bobina presa carregando por ~1s quando o
    compare match ja tinha passado - causa provavel de travamento/reset
    do MCU entre 2500-5000 RPM.
    - setIgnitionSchedule() descartava o evento de ignicao inteiro quando o
    dwell nao cabia antes do angulo de faisca (startTime=0), em vez de
    disparar no menor atraso seguro (o clamp que ja existia pra isso).
    Simulador de bancada (simulator.ino) agora fecha o loop de validacao:
    le IGN1/IGN2 da ECU com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
    [basics.sim1]
2026-09-01 Adiciona porte funcional para STM32F103C8T6 (Blue Pill)
    Novo env:bluepill no platformio.ini. O firmware inteiro continua
    compilando para AVR sem mudanca de comportamento; a porta STM32 e feita
    via #ifdef __AVR__ nos poucos pontos que tocavam registrador direto:
    - scheduler.h/.cpp: Timer1 (agendamento de ignicao) abstraido atras de
    getTimer1Count()/setTimer1CompareA()/setTimer1CompareB(). No STM32 vira
    um HardwareTimer(TIM2) com prescaler calibrado para o mesmo tick de
    16us do AVR, entao US_TO_TIMER1 e todo o resto do codigo nao mudam.
    - auxiliaries.cpp: mesmo padrao para o PWM por software do IAC (Timer2 no
    AVR -> TIM3 no STM32, mesma frequencia de ~3968Hz).
    - board_config.h: nova s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
2026-09-01 Corrige regressao de timing de ignicao introduzida pelo porte STM32
    O commit anterior (porte STM32) trocou os ponteiros crus para OCR1A/OCR1B
    por ponteiros de funcao (setTimer1CompareA/B) na ISR de ignicao, para
    compartilhar a logica entre AVR e STM32. Isso impede o compilador de
    inlinar a escrita do compare dentro da ISR do AVR - a chamada indireta
    (icall) some raramente importa em RPM baixo, mas a margem de tempo do
    compare match aperta com o RPM, e a latencia extra fazia a ignicao comecar
    a falhar de forma consistente (IGN1/IGN2 MISSING no simulador) a partir de
    uma certa faixa de RPM, sem se recuperar depois.
    Fix: handleIgnitionChannel/armIgnitionCompare agora tem duas sobrecargas,
    esco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
    [scheduler.cpp]
2026-09-01 build.sh: limpa diretorio de build inteiro antes de compilar e mostra hash
    rm -rf do .pio/build/<env> em vez de so remover hex/elf, garantindo que
    nao sobra .o intermediario de build anterior. Imprime o sha256 do .hex
    gerado no final, util pra confirmar visualmente que o binario mudou de
    fato quando o simulador/gravador (ex: SimulIDE com Auto_Load="false")
    nao recarrega sozinho.
    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
2026-09-04 docs: atualiza métricas de RAM da branch tiny no README (646B -> 587B)
    Claude-Session: https://claude.ai/code/session_01HzwDLm19aT7yNJTBhpWp9a
2026-09-04 new schematic
2026-09-26 Corrige serial do porte STM32 Blue Pill (issue #4)
    O TunerStudio nao conectava no Blue Pill por nenhum caminho:
    - USB CDC nao estava habilitada no env:bluepill, entao o firmware nao
    expunha porta serial pela USB nativa.
    - Sem CDC, o Serial do variant generico F103C8 e a USART2 (PA2/PA3),
    mas esses pinos eram MAP e TPS. O analogRead() os colocava em modo
    analogico e matava a UART logo apos o boot.
    Correcao:
    - Habilita USB CDC (Serial = USB nativa em PA11/PA12).
    - Move MAP para PB0 e TPS para PB1 (ADC1 canais 8/9), deixando
    PA2/PA3 livres.
    - build.sh aceita bluepill e aponta para o firmware.bin.
    [board_config.h]
